artiommorozov/boiler-room/roomDrawing/drawing.pdf

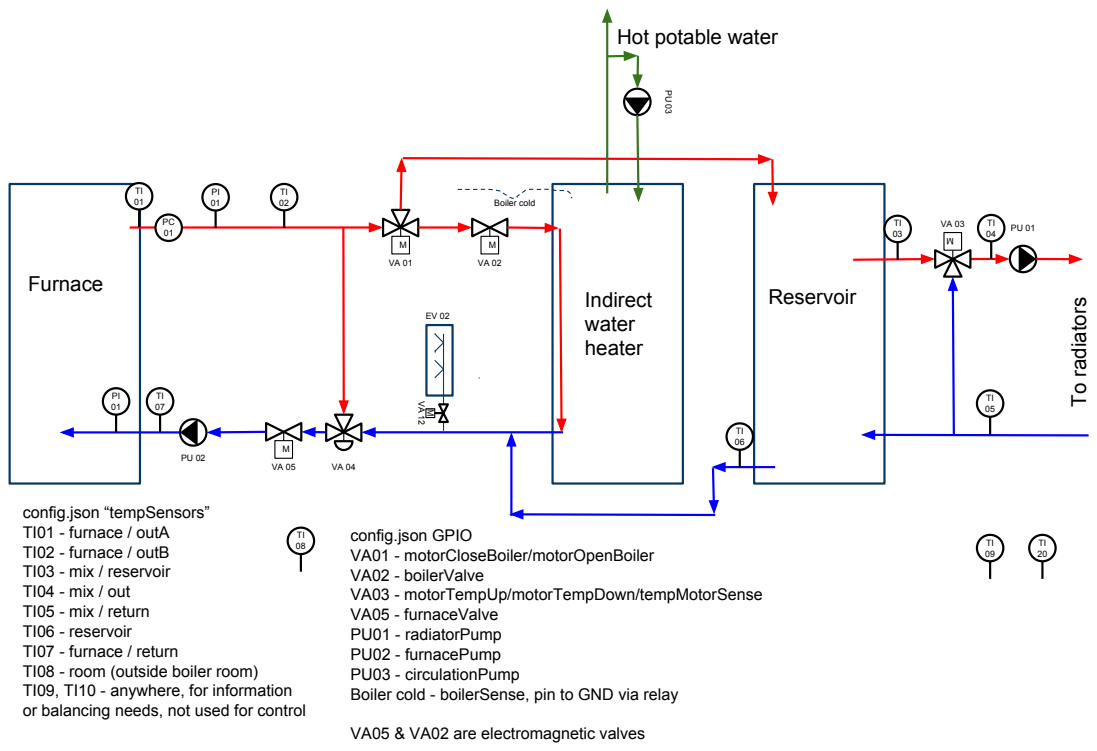
[picture p1: page 1]
Furnace; Indirect water heater; Reservoir; To radiators; Boiler cold

Hot potable water

config.json “tempSensors”
TI01 - furnace / outA
TI02 - furnace / outB
TI03 - mix / reservoir
TI04 - mix / out
TI05 - mix / return
TI06 - reservoir
TI07 - furnace / return
TI08 - room (outside boiler room)
TI09, TI10 - anywhere, for information
or balancing needs, not used for control

config.json GPIO
VA01 - motorCloseBoiler/motorOpenBoiler
VA02 - boilerValve
VA03 - motorTempUp/motorTempDown/tempMotorSense
VA05 - furnaceValve
PU01 - radiatorPump
PU02 - furnacePump
PU03 - circulationPump
Boiler cold - boilerSense, pin to GND via relay

VA05 & VA02 are electromagnetic valves
