artiommorozov/boiler-room/schematics/cpu.kicad_pcb

## KiCad design 3_3vdc_out.sch


Parts:
C8, C9: 10nF
R1: 240R
R2: 402R
U4: LM317_TO3; TO-3

Connections:
+3.3: C9.1, R1.1, U4.3 (VO)
GND: C8.2, C9.2, R2.2
unnamed: R1.2, R2.1, U4.1 (ADJ)
VCC: C8.1, U4.2 (VI)
