artiommorozov/boiler-room/schematics/cpu.kicad_pcb

## KiCad design 5vdc_out.sch


Parts:
C6, C7: 10nF
U3: LM7805_TO220; TO-220-3_Vertical

Connections:
+5: C7.1, U3.3 (VO)
GND: C6.2, C7.2, U3.2 (GND)
VCC: C6.1, U3.1 (VI)
