artiommorozov/boiler-room/schematics/cpu.kicad_pcb

## KiCad design 9vdc_out.sch


Parts:
C4, C5: 10nF
U2: LM7809_TO220; TO-220-3_Vertical

Connections:
+9: C5.1, U2.3 (VO)
GND: C4.2, C5.2, U2.2 (GND)
VCC: C4.1, U2.1 (VI)
