artiommorozov/boiler-room/schematics/cpu.kicad_pcb

## KiCad design 12vdc_out.sch


Parts:
C2, C3: 10nF
U1: LM7812; TO-220-3_Vertical

Connections:
+12: C3.1, U1.3 (VO)
GND: C2.2, C3.2, U1.2 (GND)
VCC: C2.1, U1.1 (VI)
