artiommorozov/boiler-room/schematics/cpu.kicad_pcb

## KiCad design 220vac.sch


Parts:
C1: 470uF
D1: D_Bridge_+-AA
J1: 220VAC in
T1: Transformer

Connections:
GND: C1.2, D1.2 (-)
unnamed: D1.3 (~~), T1.4 (SB)
unnamed: D1.4 (~~), T1.3 (SA)
unnamed: J1.1, T1.2 (AB)
unnamed: J1.2, T1.1 (AA)
VCC: C1.1, D1.1 (+)
