artiommorozov/boiler-room/(commit log)

2018-09-30 temp sensors on
    [cpu.kicad_pcb, cpu.sch]
2018-10-26 wip, fixes to different places
    [Control.h, Ds18b20.h, Ds2482.h, Mixer.h, TempSensor.cpp]
2018-11-09 better sample config
2018-11-13 fixed control stuck in heat dump state if furnace becomes hotter than reservoir after pump stop
    [Control.h]
2020-09-19 added radiator pump rundown time
2021-10-01 fixed extra heat dump state stuck
    [Temperature.h]
2021-10-16 adding secondary heat source
2021-12-04 fixed secondary (soft) heat source start condition
    [Control.h, Temperature.h, main.cpp]
2021-12-04 updated schema
    [cpu.sch]
2022-12-19 fixed missing hard heat mode start if mix went lower than reservoir bottom while heating boiler
    [Control.h]
2023-02-25 changed valve open order
2025-09-16 K293KP11B proved unreliable on currents over 1A with radiator pump. after replacing two optrons decided to fallback to regular relay for radiator pump circuit. note 360Ohm in control line removed or 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
    [cpu.sch]
